AbdelrahmanMoataz/Aquaphoton-Training-MegaProject-24/Hardware/COPPER LAYER + STICKER(ESP_Circuit).PDF

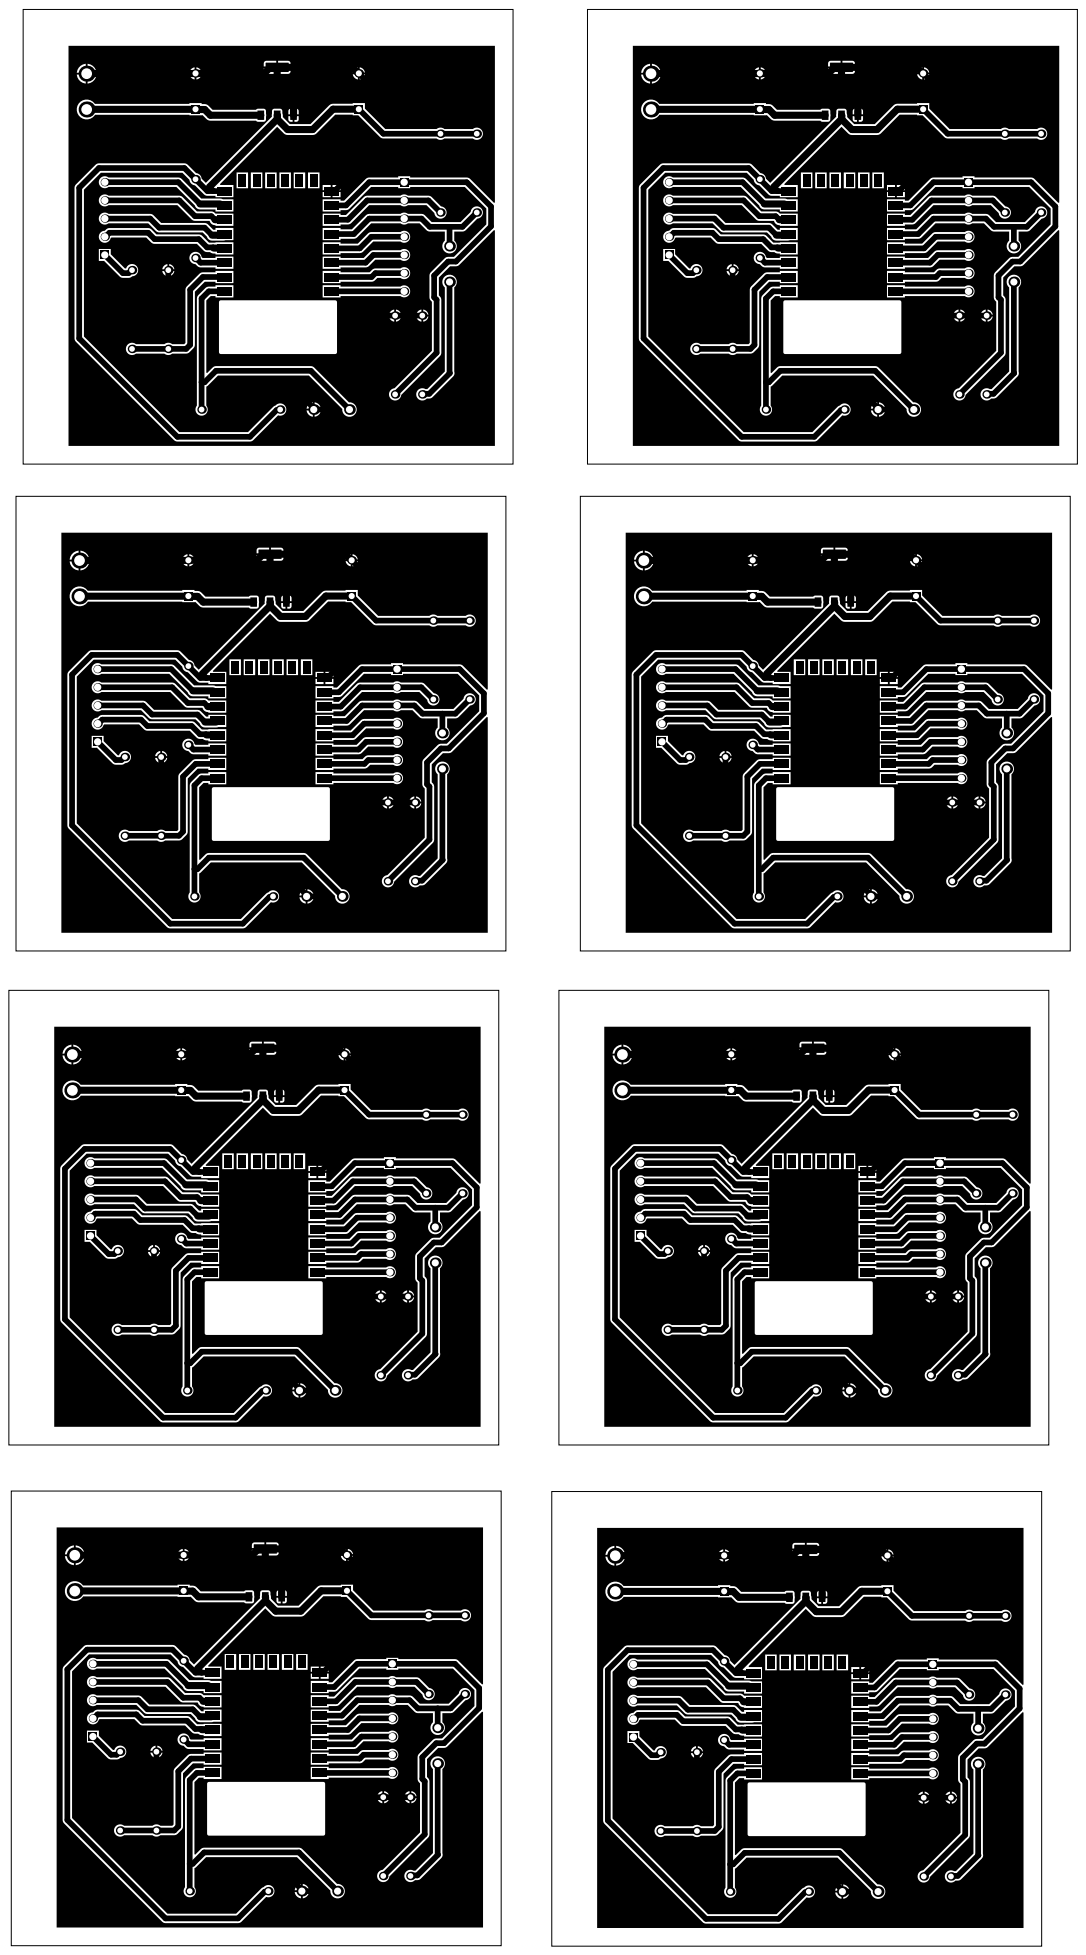
[picture p32: page 1]

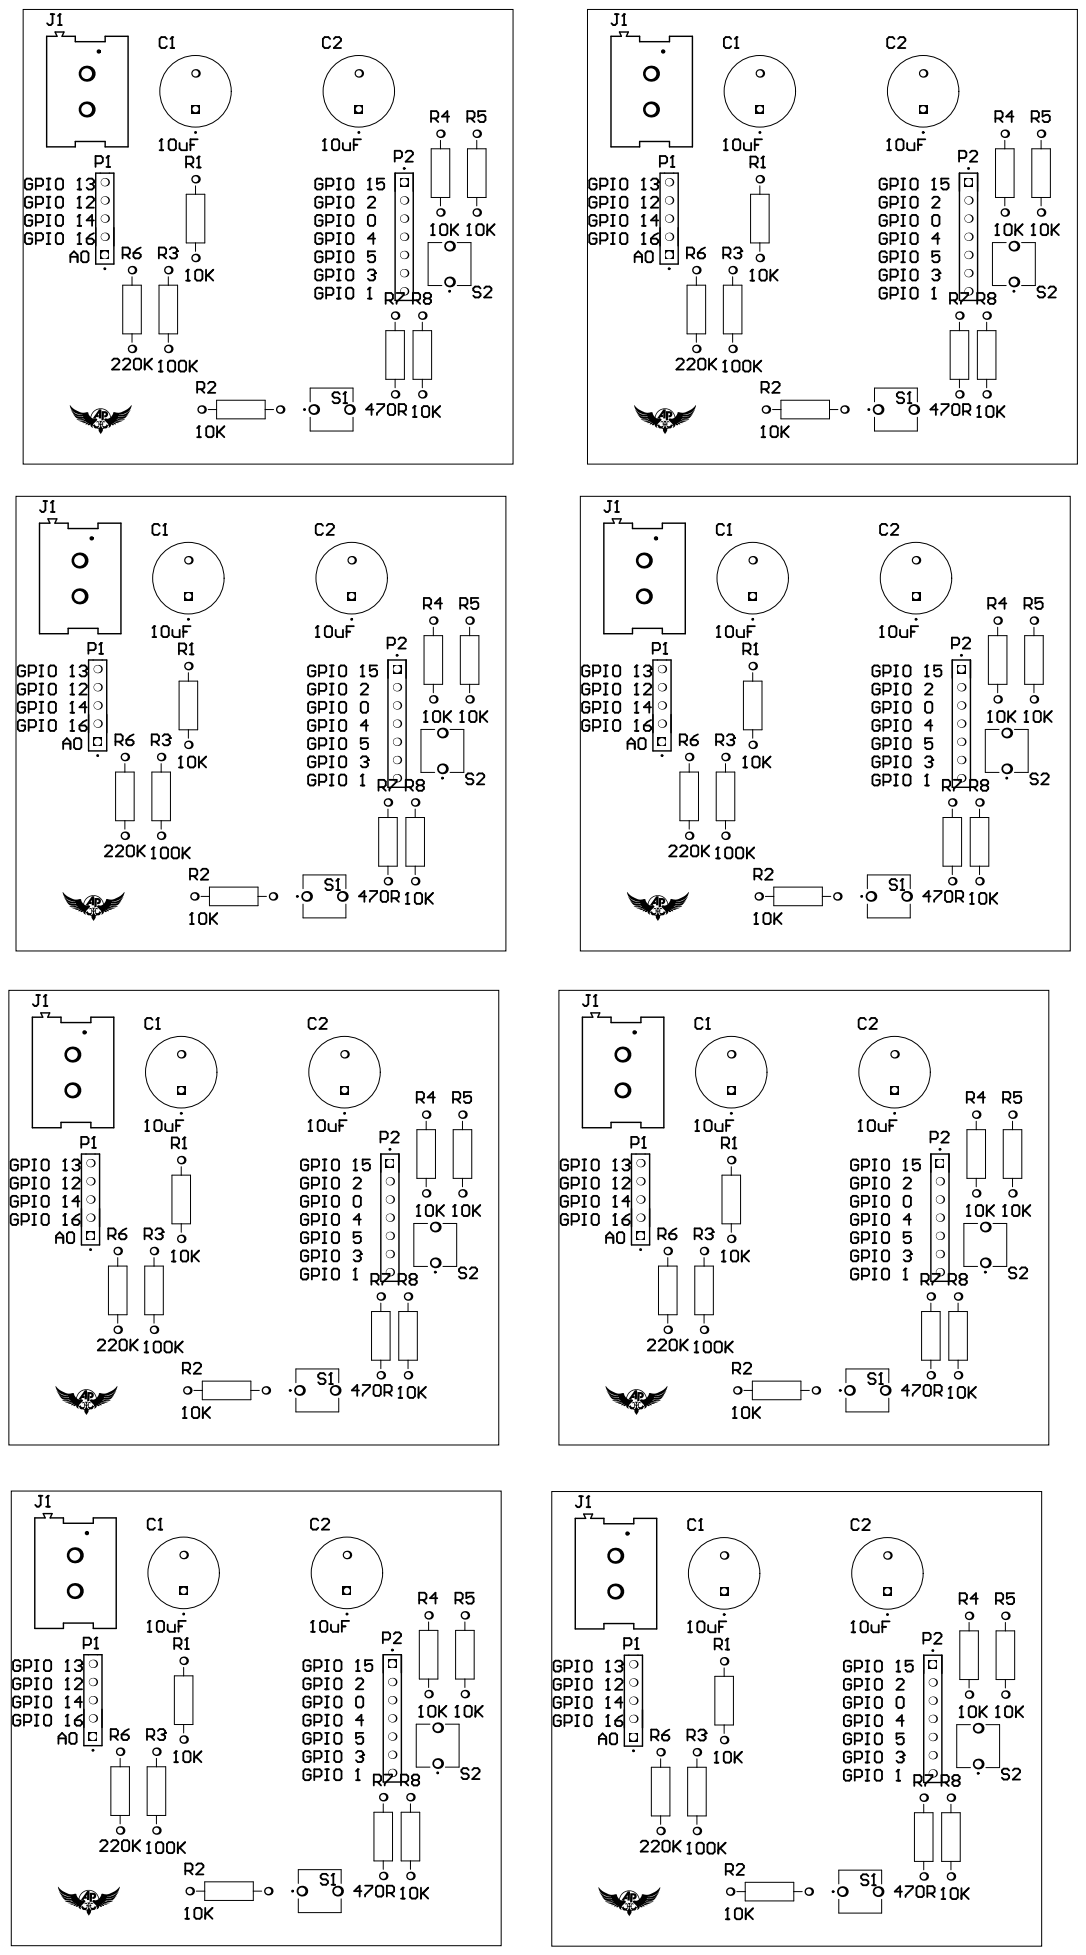
[picture p33: page 2]
