AbdelrahmanMoataz/Aquaphoton-Training-MegaProject-24/(list of files, drawings)

Other design files:
Hardware/MegaProject_PCB/ESP_Circuit2.PcbDoc
Hardware/MegaProject_PCB/ESP_Circuit.SchDoc
Hardware/MegaProject_PCB/Main_Circuit.SchDoc
Hardware/MegaProject_PCB/MegaProject_ESP_PCB.PrjPcb
Hardware/MegaProject_PCB/MegaProject_Lib.PcbLib
Hardware/MegaProject_PCB/MegaProject_Lib.SchLib
Hardware/MegaProject_PCB/PRINT.PcbDoc
Hardware/MegaProject_PCB_Main/MegaProject_ESP_Main/Main_Circuit.PcbDoc
Hardware/MegaProject_PCB_Main/MegaProject_ESP_Main/Main_Circuit.SchDoc
Hardware/MegaProject_PCB_Main/MegaProject_ESP_Main/MegaProject_ESP_Main.PrjPcb
Hardware/MegaProject_PCB_Main/MegaProject_ESP_Main/MegaProject_Lib.PcbLib
Hardware/MegaProject_PCB_Main/MegaProject_ESP_Main/MegaProject_Lib.SchLib
